project802/ic-705_audio_interface/images/Digirig_IC-705_Interface_Cable.png

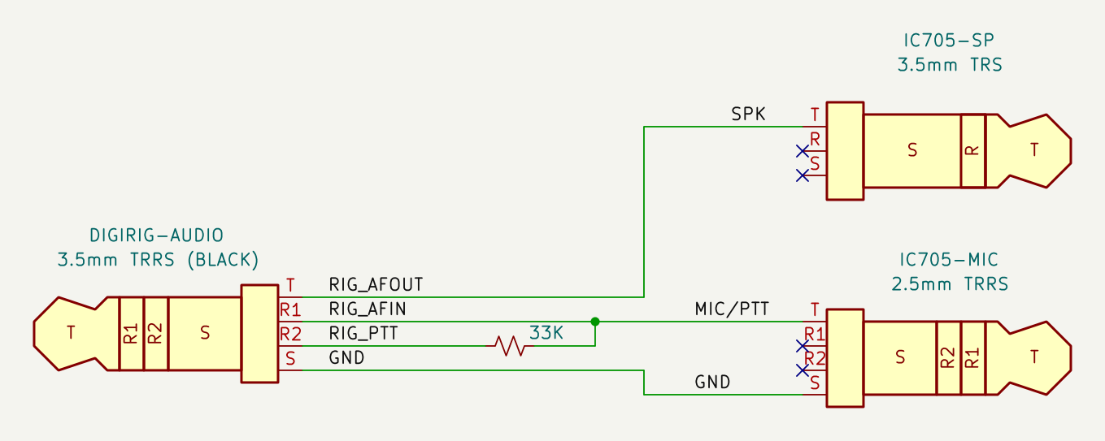
images/Digirig_IC-705_Interface_Cable.png
