project802/ic-705_audio_interface/images/ic-705_audio_interface_schematic.JPG

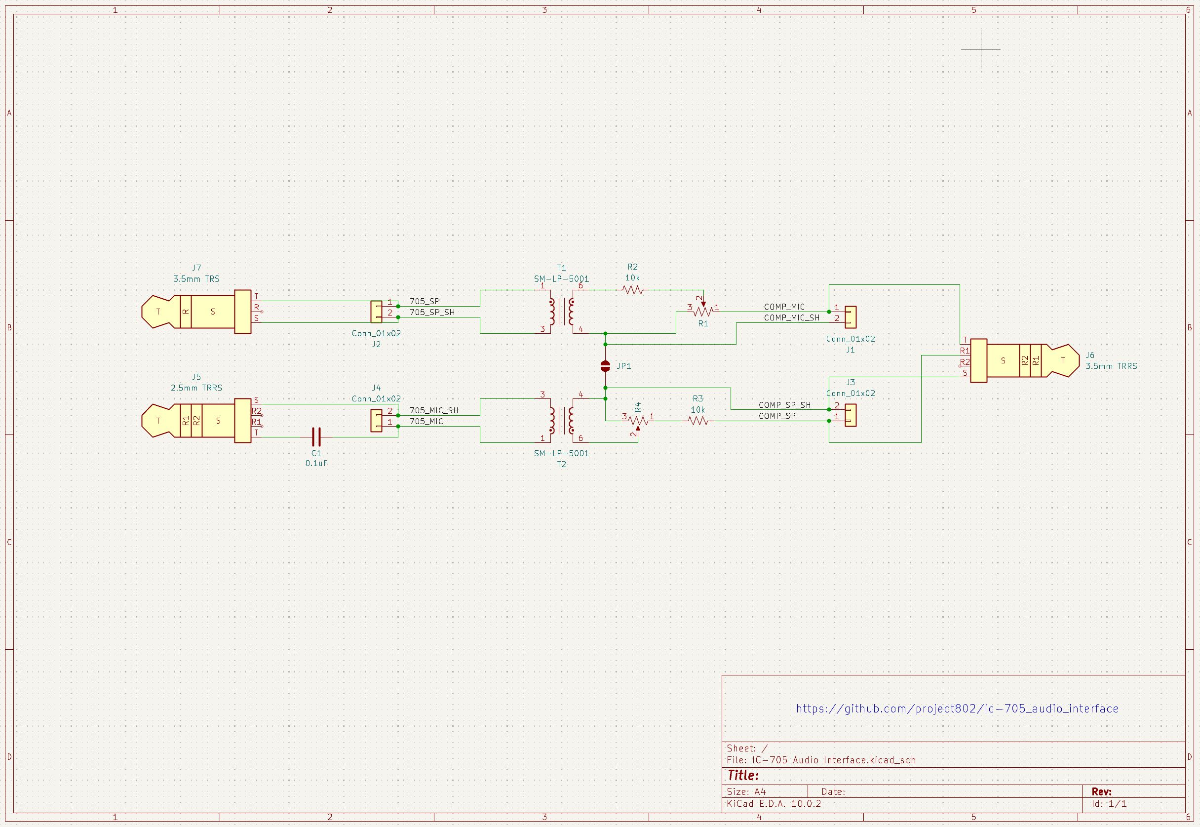
images/ic-705_audio_interface_schematic.JPG
