project802/ic-705_audio_interface/images/Icom_example_interface.JPG

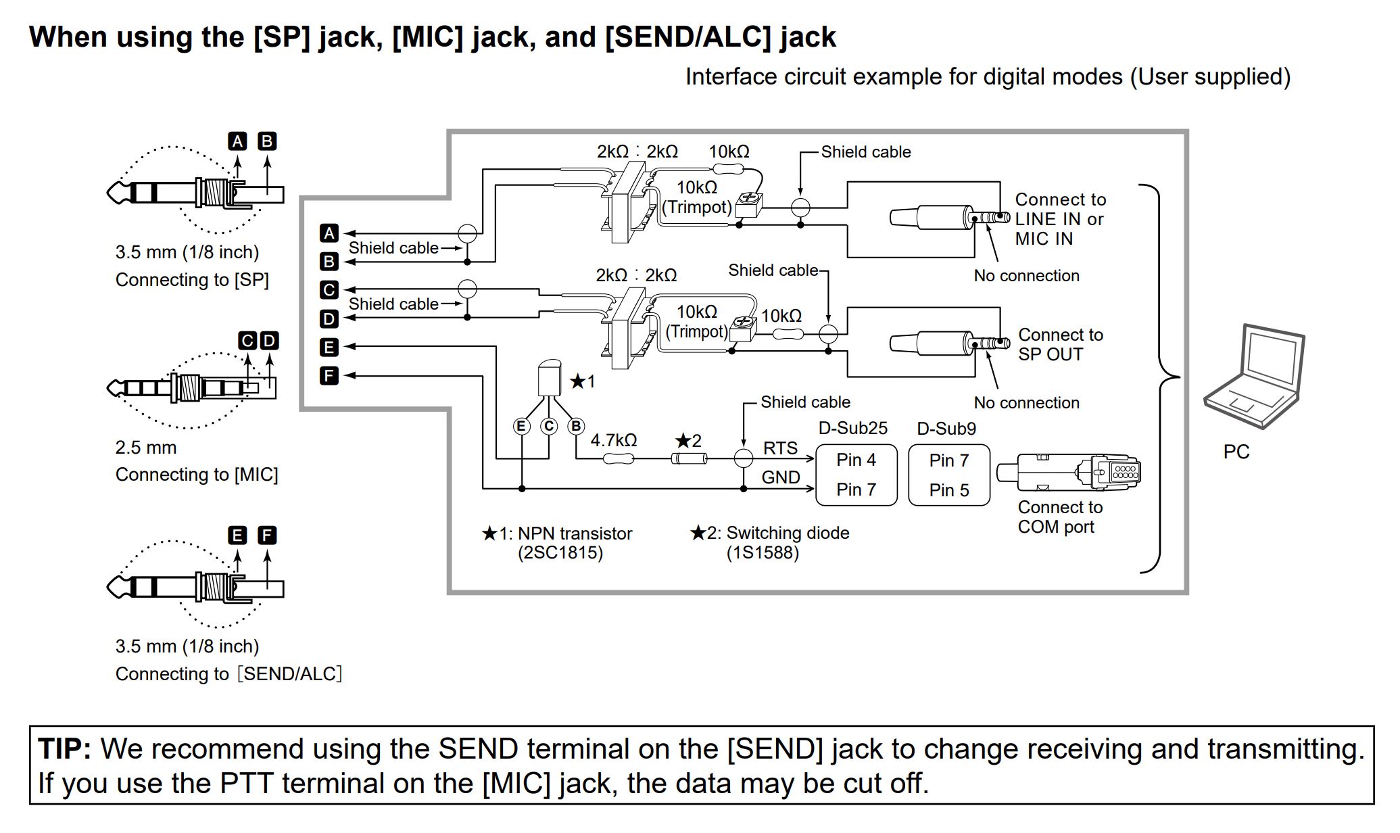
images/Icom_example_interface.JPG
