project802/ic-705_audio_interface/images/interface_solo.JPG

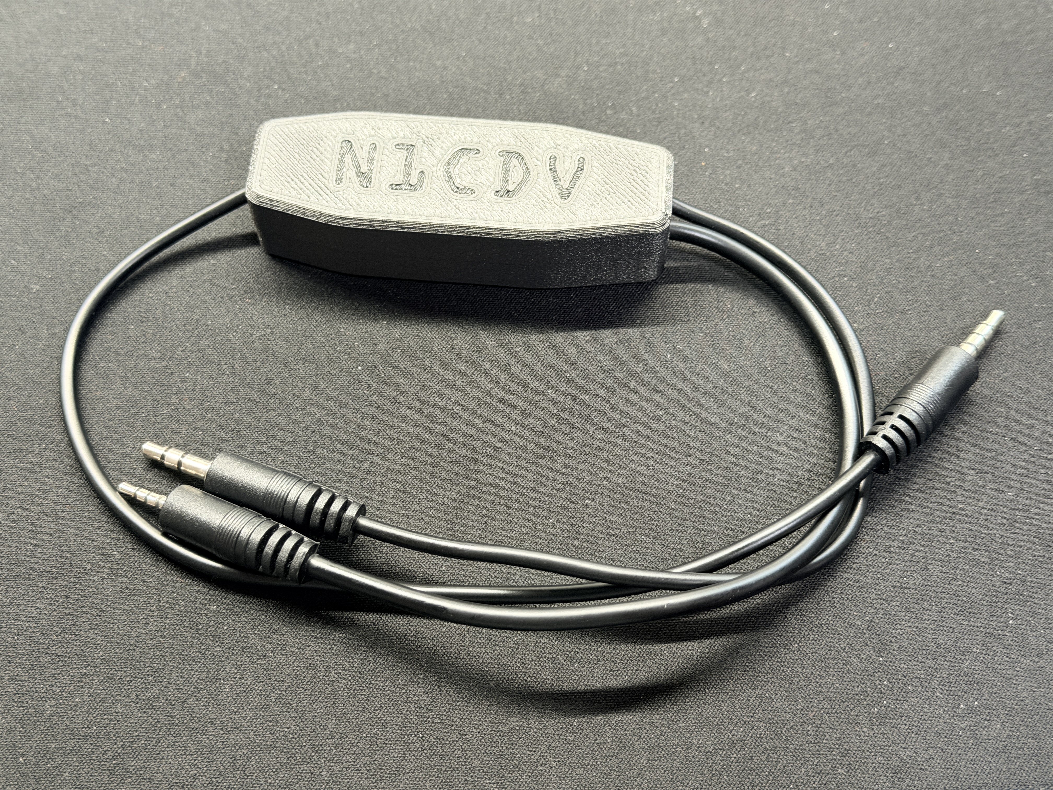
images/interface_solo.JPG
