project802/ic-705_audio_interface/KiCad/3D Files/CTS 09TR07AA103CP.step

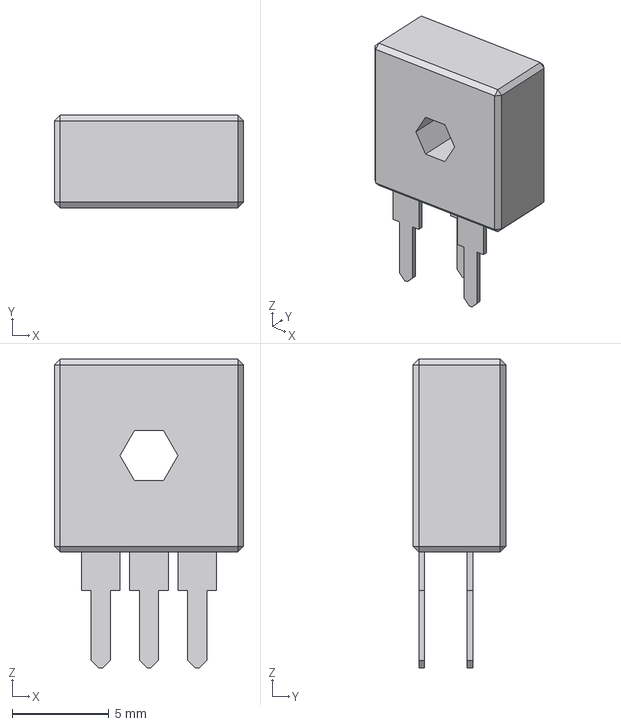
[picture p8: CAD file, 2026-09-26]
KiCad/3D Files/CTS 09TR07AA103CP.step
9.80 x 4.80 x 16.0 mm
