project802/ic-705_audio_interface/KiCad/3D Files/sm-lp-5001.stp

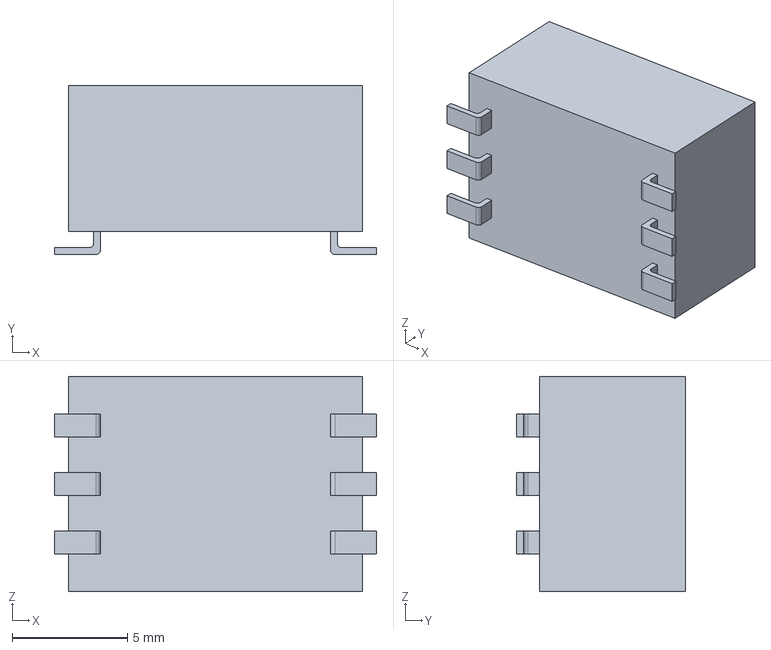
[picture p9: CAD file, 2026-09-26]
KiCad/3D Files/sm-lp-5001.stp
14.0 x 7.36 x 9.35 mm
