project802/ic-705_audio_interface/KiCad/IC-705 Audio Interface.kicad_pcb

## KiCad design KiCad/IC-705 Audio Interface.kicad_pcb (2026-10-14)

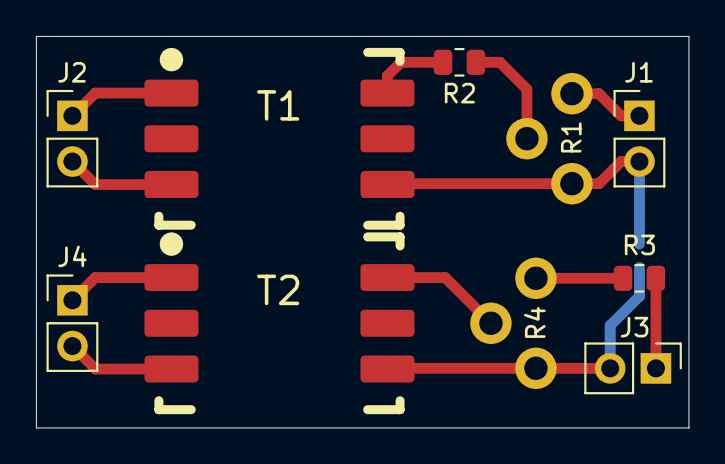
[picture p10: board IC-705 Audio Interface.kicad_pcb from above]

Board: 2 copper layers, 36.2 x 21.8 mm, 11 parts (1 on the bottom side), 12 nets.

Parts:
J1, J2, J3, J4: Conn_01x02; PinHeader_1x02_P2.54mm_Vertical
JP1: SolderJumper_2_Open; SolderJumper-2_P1.3mm_Open_RoundedPad1.0x1.5mm
R1, R4: H2.5
R2, R3: 10k; R_0805_2012Metric
T1, T2: SM-LP-5001

Connections:
/705_MIC: J4.1, T2.1
/705_MIC_SH: J4.2, T2.3
/705_SP: J2.1, T1.1
/705_SP_SH: J2.2, T1.3
/COMP_MIC: J1.1, R1.1
/COMP_MIC_SH: J1.2, JP1.1 (A), R1.3, T1.4
/COMP_SP: J3.1, R3.2
/COMP_SP_SH: J3.2, JP1.2 (B), R4.3, T2.4
unnamed: R1.2, R2.2
unnamed: R2.1, T1.6
unnamed: R3.1, R4.1
unnamed: R4.2, T2.6
