project802/ic-705_audio_interface/(commit log)

2026-09-26 Change text and remove tracks inside pads.
    [IC-705 Audio Interface.kicad_pcb]
2026-10-14 Add audio jacks
    [IC-705 Audio Interface.kicad_pcb, IC-705 Audio Interface.kicad_sch]
2026-10-14 Update connector names
    [IC-705 Audio Interface.kicad_sch]
2026-10-14 Add link to GitHub repo
    [IC-705 Audio Interface.kicad_sch]
